dotstartech/nfc-terminal-proto/README.md

# nfc-terminal-proto
NFC Terminal Prototype
