dotstartech/nfc-terminal-proto/pcb/nfc-attachment/nfc-attachment.kicad_pcb

## KiCad design pcb/nfc-attachment/nfc-attachment.kicad_pcb (2025-09-16)

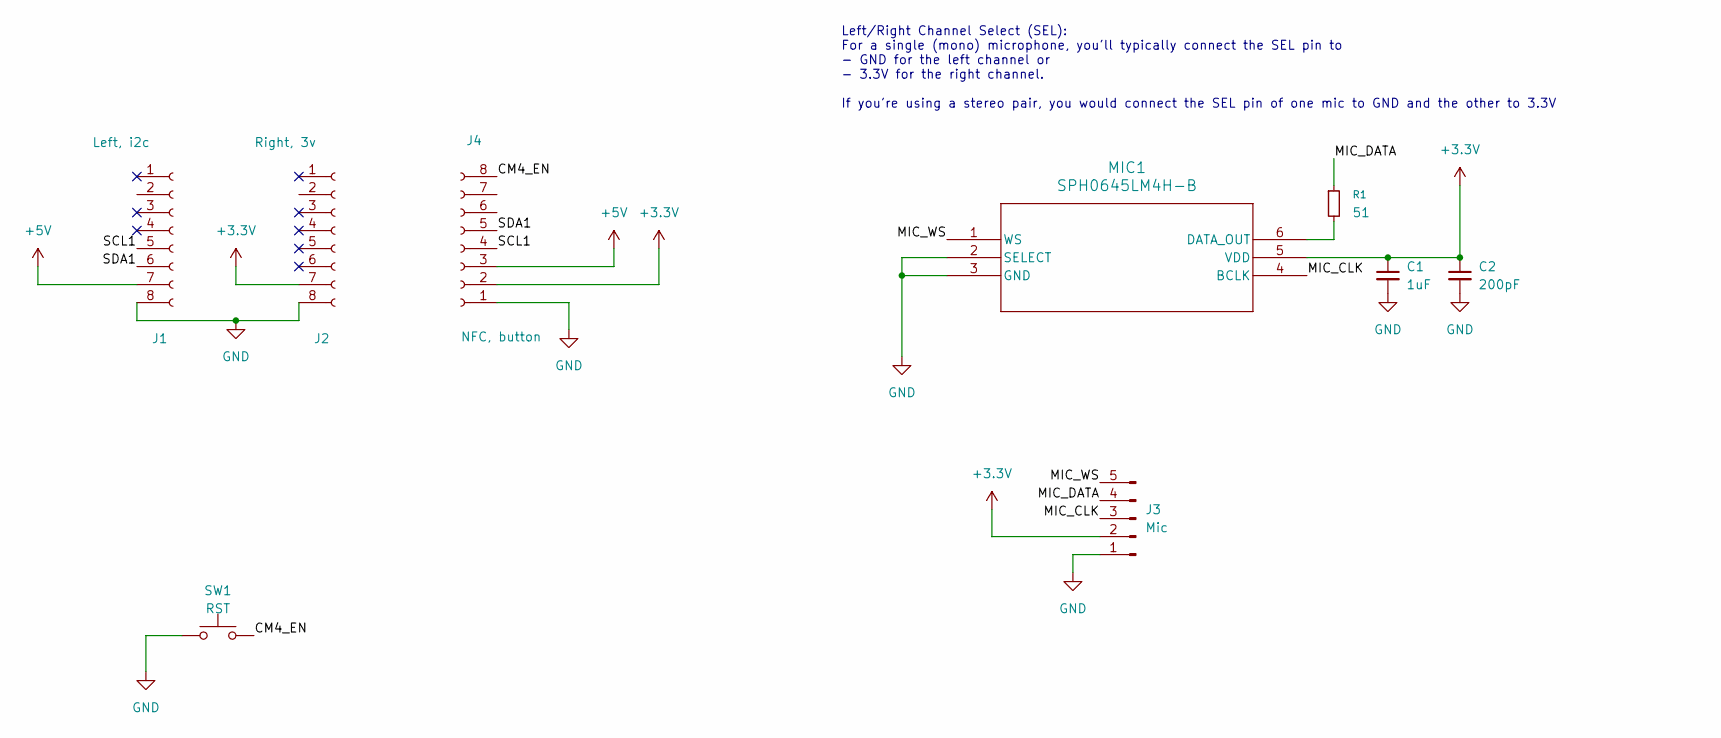
[picture p3: schematic nfc-attachment.kicad_sch]

Parts:
C1: 1uF; C_0603_1608Metric
C2: 200pF; C_0603_1608Metric
J1: Left, i2c; PinHeader_1x08_P2.54mm_Vertical
J2: Right, 3v; PinHeader_1x08_P2.54mm_Vertical
J3: Mic; PinHeader_1x05_P2.54mm_Vertical
J4: NFC, button; PinHeader_1x08_P2.54mm_Vertical
MIC1: SPH0645LM4H-B; SPH0645LM4H-B_KNO
R1: 51; R_0402_1005Metric
SW1: RST; SW_SPST_PTS810; LCSC C116501

Connections:
+3.3V: C1.1, C2.1, J2.7, J3.2, J4.2, MIC1.5 (VDD)
+5V: J1.7, J4.3
/CM4_EN: J4.8, SW1.2
/MIC_CLK: J3.3, MIC1.4 (BCLK)
/MIC_DATA: J3.4, R1.1
/MIC_WS: J3.5, MIC1.1 (WS)
/SCL1: J1.5, J4.4
/SDA1: J1.6, J4.5
GND: C1.2, C2.2, J1.8, J2.8, J3.1, J4.1, MIC1.2 (SELECT), MIC1.3 (GND), SW1.1
unnamed: MIC1.6 (DATA_OUT), R1.2

Notes on the sheet:
Left/Right Channel Select (SEL): For a single (mono) microphone, you'll typically connect the SEL pin to - GND for the left channel or - 3.3V for the right channel. If you're using a stereo pair, you would connect the SEL pin of one mic to GND and the other to 3.3V

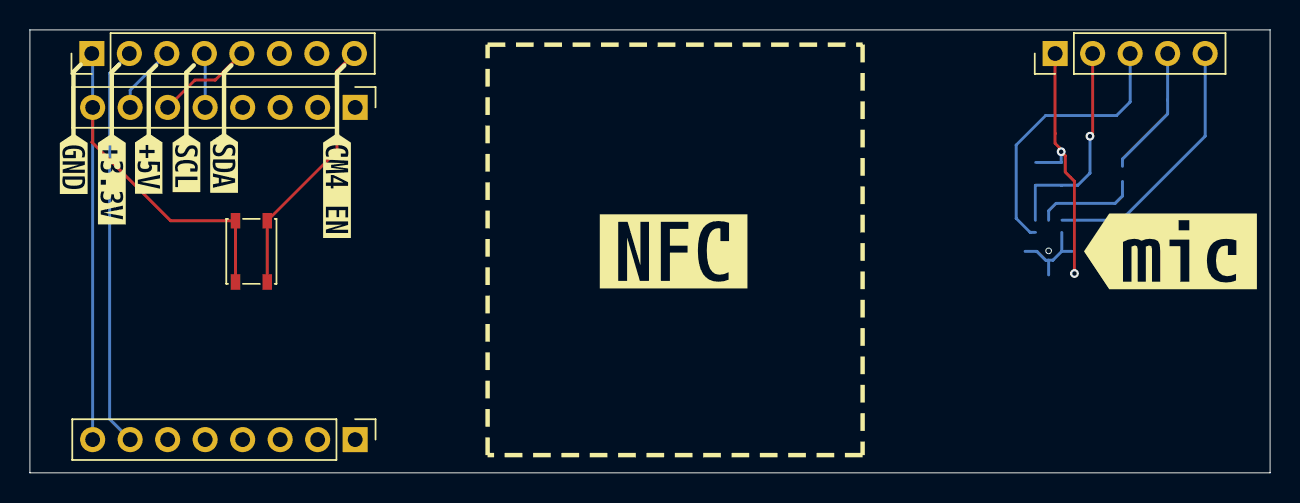
[picture p4: board nfc-attachment.kicad_pcb from above]

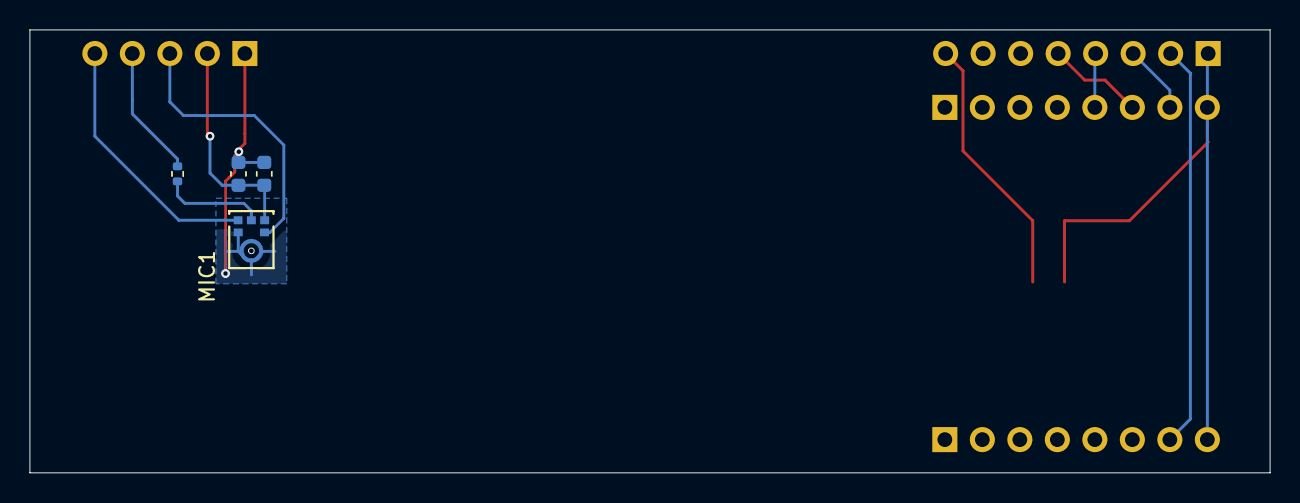
[picture p5: board nfc-attachment.kicad_pcb from below]

Board: 2 copper layers, 84.0 x 30.0 mm, 17 parts (4 on the bottom side), 10 nets.

Other parts of the board:
kibuzzard-68ADC165: G***; kibuzzard-68ADC165
kibuzzard-68ADC191: G***; kibuzzard-68ADC191
kibuzzard-68AEE2C2: G***; kibuzzard-68AEE2C2
kibuzzard-68AEE2D0: G***; kibuzzard-68AEE2D0
kibuzzard-68AEE2DF: G***; kibuzzard-68AEE2DF
kibuzzard-68AEE21F: G***; kibuzzard-68AEE21F
kibuzzard-68AEE211: G***; kibuzzard-68AEE211
kibuzzard-68AEE235: G***; kibuzzard-68AEE235
