dotstartech/nfc-terminal-proto/pcb/poe-back-plate/poe-back-plate.kicad_pcb

## KiCad design pcb/poe-back-plate/poe-back-plate.kicad_pcb (2025-09-16)

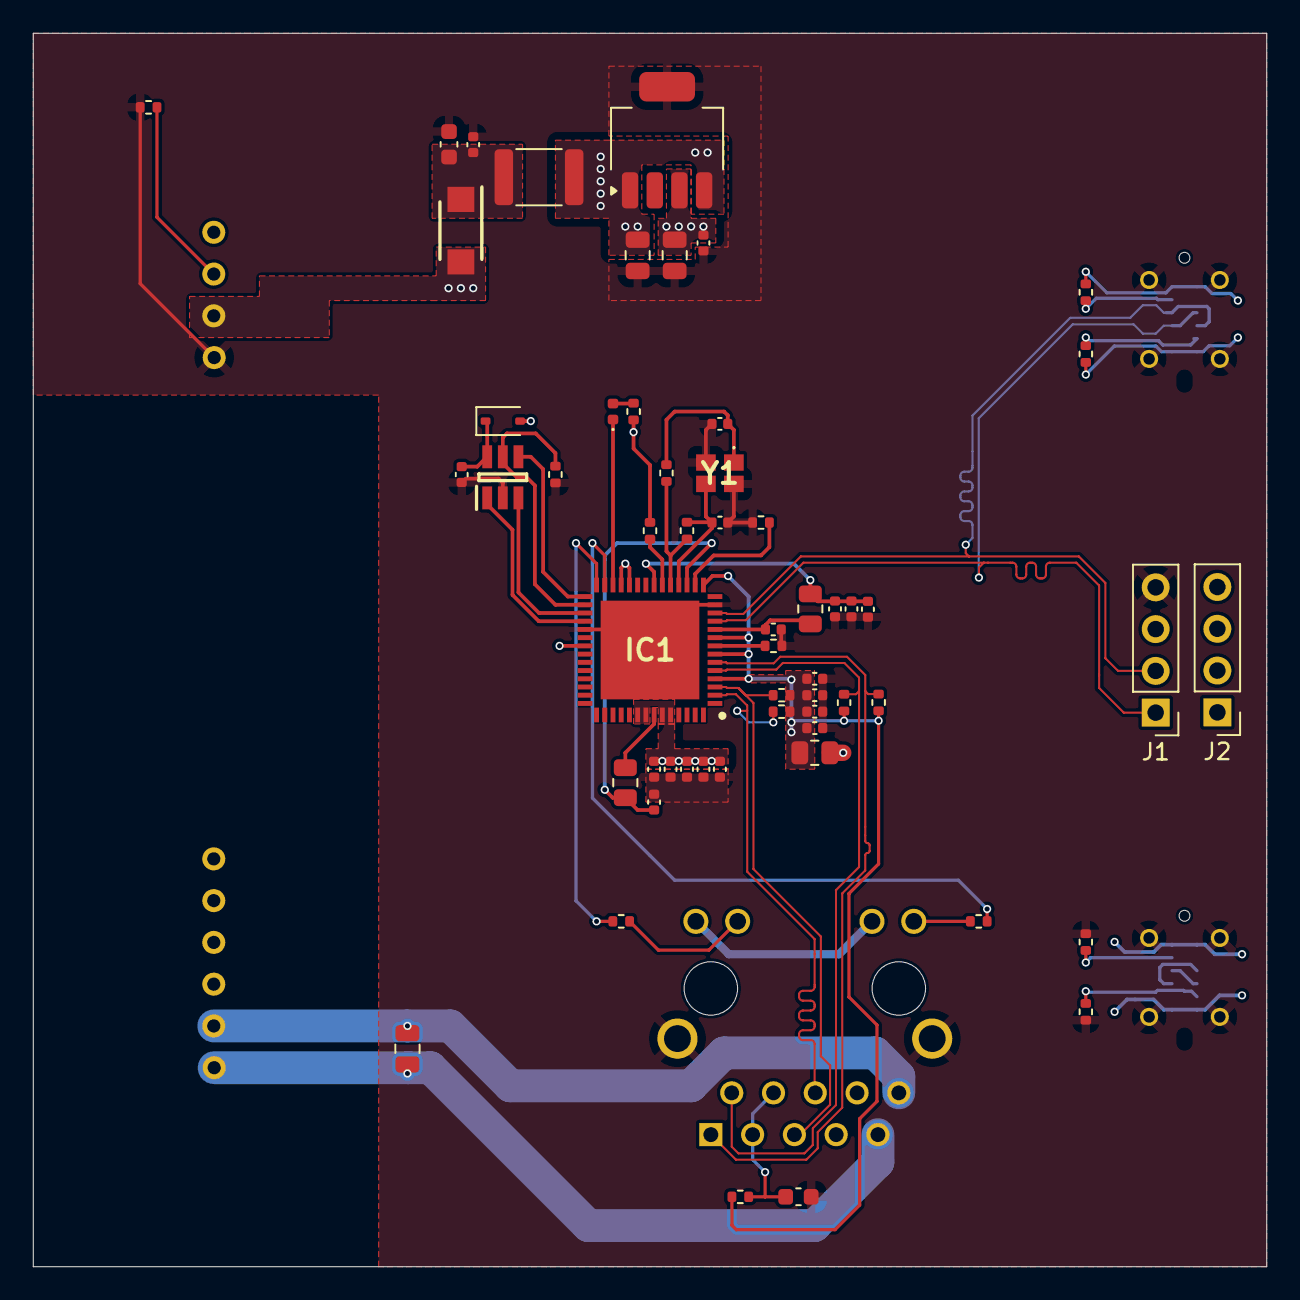
[picture p6: board poe-back-plate.kicad_pcb from above]

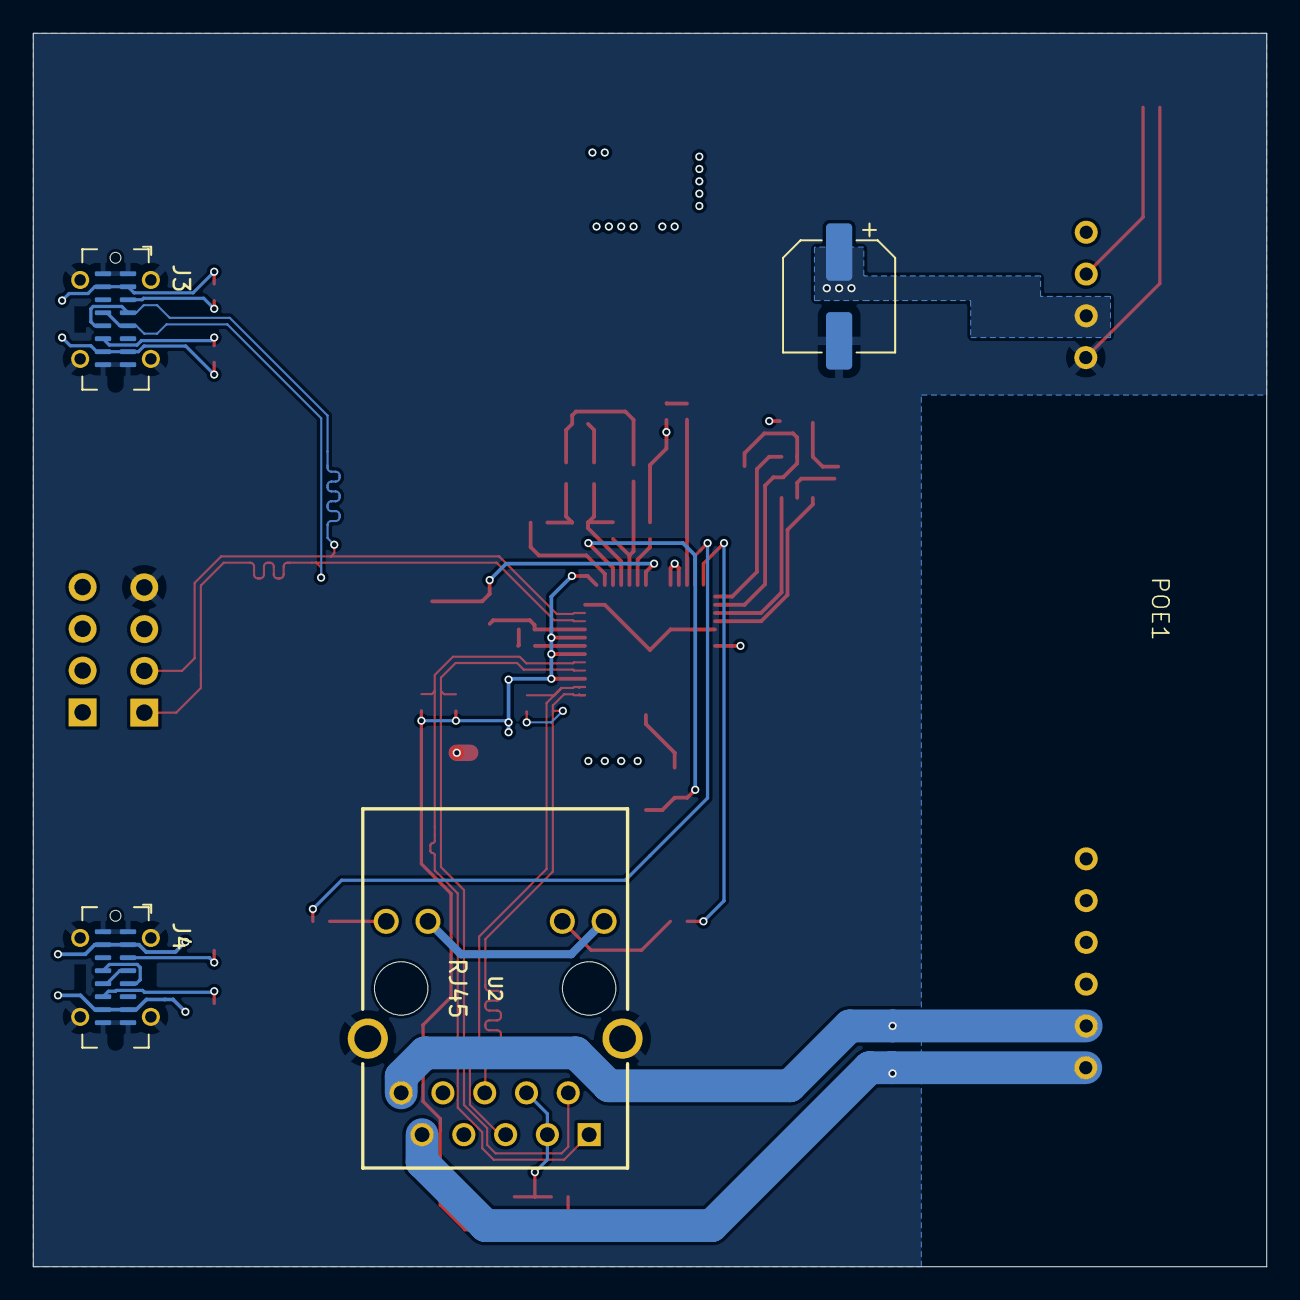
[picture p7: board poe-back-plate.kicad_pcb from below]

Board: 6 copper layers, 75.0 x 75.0 mm, 61 parts (5 on the bottom side), 42 nets.

Parts:
C1, C2, C3, C4, C5, C6, C7, C8, C9, C11, C12, C13, C14, C16, C20, C22: 100nF; C_0402_1005Metric
C10: 1uF; C_0402_1005Metric
C15, C18: 24pF; C_0402_1005Metric
C17, C19: 1uF; C_0805_2012Metric
C21: 1uF; C_0603_1608Metric
C23: 22nF; C_0603_1608Metric
C24: 10nF; C_0805_2012Metric
C25: 470µF; CP_Elec_6.3x7.7
D1: GREEN; LED_0402_1005Metric
D2: B0540WS; D_SOD-323
D3: SS54F; SODFL4626X120N
FB1, FB2, FB3: BLM21PG221SN1D; R_0805_2012Metric
FB4: CBM453215U101T; R_1812_4532Metric
IC1: LAN9500A-ABZJ; QFN50P800X800X100-57N-D
IC2: 93LC66AT-I_OT; SOT95P270X145-6N
J1: USB + Power; PinHeader_1x04_P2.54mm_Vertical
J2: UART + I2C; PinHeader_1x04_P2.54mm_Vertical
J3, J4: USB_C_Receptacle_USB2.0_14P; USB_C_Receptacle_G-Switch_GT-USB-7051x
POE1: AG5405
R1, R2: 12K; R_0402_1005Metric
R3, R5: 0; R_0402_1005Metric
R4: 1M; R_0402_1005Metric
R6, R12, R13: 3.3K; R_0402_1005Metric
R7: 10K; R_0402_1005Metric
R8, R10: 56K; R_0402_1005Metric
R9, R11: 5.1K; R_0402_1005Metric
R14: 10; R_0402_1005Metric
R15, R16, R17, R18: 49.9; R_0402_1005Metric
R19: 50K; R_0402_1005Metric
U1: LP38693MP-3.3; SOT-223-5
U2: HY931147C
Y1: ECS-250-18-36B2-CTY-TR; ECS2501836B2CTYTR

Connections:
+3.3V: C1.2, C2.2, C4.2, C6.2, C8.2, C19.2, C20.2, D2.2 (A), FB1.1, IC1.24 (NRESET), IC1.25 (VDD33IO_1), IC1.35 (VDD33IO_2), IC1.48 (VDD33IO_3), IC1.49 (TEST1), IC1.51 (VDD33IO_4), IC1.52 (VDD33IO_5), R3.1, R6.2, U1.3 (OUT), U2.P$11 (Y+), U2.P$13 (G+)
+5V: C17.2, FB4.2, J1.3, J3.A4 (VBUS), J3.A9 (VBUS), J3.B4 (VBUS), J3.B9 (VBUS), J4.A4 (VBUS), J4.A9 (VBUS), J4.B4 (VBUS), J4.B9 (VBUS), R8.2, R10.2, U1.1 (EN), U1.4 (IN)
/PoE/ETH1_LEDG: IC1.27 (NLNKA_LED/GPIO9), R12.2
/PoE/ETH1_LEDY: IC1.28 (NSPD_LED/GPIO10), R13.2
/PoE/POE_5V: C21.1, C22.1, D3.1 (K), FB4.1
/PoE/RXN: IC1.5 (RXN), R15.2, U2.P$2 (RX-)
/PoE/RXP: IC1.6 (RXP), R16.2, U2.P$1 (RX+)
/PoE/TXN: IC1.2 (TXN), R17.2, U2.P$6 (TX-)
/PoE/TXP: IC1.3 (TXP), R18.2, U2.P$5 (TX+)
/PoE/VDD33A: C3.2, C5.2, C7.2, C9.2, FB1.2, IC1.4 (VDD33A_1), IC1.7 (NC_1), IC1.9 (VDD33A_2), IC1.15 (VDD33A_3), R14.1, R15.1, R16.1, R17.1, R18.1
/USB to Ethernet/CRYSTAL_XI: C18.2, IC1.18 (XI), R4.2, Y1.3 (OUT/IN)
/USB to Ethernet/CRYSTAL_XO: IC1.19 (XO), R4.1, R5.1
/USB to Ethernet/EECLK_GPIO3: IC1.29 (EECLK/PWR_SEL), IC2.4 (CLK)
/USB to Ethernet/EECS_GPIO0: IC1.30 (EECS), IC2.5 (CS), R7.1
/USB to Ethernet/EEDI_GPIO1: IC1.32 (EEDI), IC2.1 (DO)
/USB to Ethernet/EEDO_GPIO2: IC1.31 (EEDO/AUTOMDIX_EN), IC2.3 (DI)
/USB to Ethernet/ETH1_LED_FDX: D1.1 (K), IC1.26 (NFDX_LED/GPIO8)
/USB to Ethernet/USBDN: IC1.11 (USBDM), J1.1, J3.A7 (D-), J3.B7 (D-)
/USB to Ethernet/USBDP: IC1.12 (USBDP), J1.2, J3.A6 (D+), J3.B6 (D+)
/USB to Ethernet/VDDCORE: C10.2, C11.2, C12.2, FB2.1, FB3.1, IC1.21 (VDDCORE_1), IC1.50 (VDDCORE_2)
/USB to Ethernet/VDDPLL: C14.2, FB3.2, IC1.10 (VDDPLL)
/USB to Ethernet/VDDUSBPLL: C13.2, FB2.2, IC1.17 (VDDUSBPLL)
GND: C1.1, C2.1, C3.1, C4.1, C5.1, C6.1, C7.1, C8.1, C9.1, C10.1, C11.1, C12.1, C13.1, C14.1, C15.1, C16.1, C17.1, C18.1, C19.1, C20.1, C21.2, C22.2, C23.2, C25.2, IC1.13 (TEST2), IC1.33 (TEST3), IC1.57 (VSS), IC2.2 (VSS), J1.4, J3.A1 (GND), J3.A12 (GND), J3.B1 (GND), J3.B12 (GND), J3.S1 (SHIELD), J4.A1 (GND), J4.A12 (GND), J4.B1 (GND), J4.B12 (GND), J4.S1 (SHIELD), POE1.7 (-VDC), R1.1, R2.1, R7.2, R9.2, R11.2, R19.2, U1.5 (GND), U2.GND1, U2.GND2, Y1.2 (GND_1), Y1.4 (GND_2)
unnamed: D1.2 (A), R6.1
unnamed: C16.2, D2.1 (K), IC2.6 (VCC)
unnamed: C25.1, D3.2 (A), POE1.8 (+VDC_)
unnamed: IC1.8 (EXRES), R1.2
unnamed: IC1.16 (USBRBIAS), R2.2
unnamed: IC1.20 (VBUS_DET), R3.2
unnamed: J3.A5 (CC1), R8.1
unnamed: J3.B5 (CC2), R10.1
unnamed: J4.A5 (CC1), R9.1
unnamed: J4.B5 (CC2), R11.1
unnamed: J4.A6 (D+), J4.B6 (D+)
unnamed: J4.A7 (D-), J4.B7 (D-)
unnamed: POE1.9 (ADJ), R19.1
unnamed: C24.1, POE1.1 (VIN+), U2.P$9 (V+)
unnamed: C24.2, POE1.2 (VIN-), U2.P$10 (V-)
unnamed: R12.1, U2.P$14 (G-)
unnamed: C23.1, R14.2, U2.P$3 (RXCT), U2.P$4 (TXCT)
unnamed: R13.1, U2.P$12 (Y-)
unnamed: C15.2, R5.2, Y1.1 (IN/OUT)
