dotstartech/nfc-terminal-proto/pcb/nfc-terminal-cm4-carrier/CM4IOv5.kicad_pcb

## KiCad design pcb/nfc-terminal-cm4-carrier/CM4IOv5.kicad_pcb (2025-09-16)

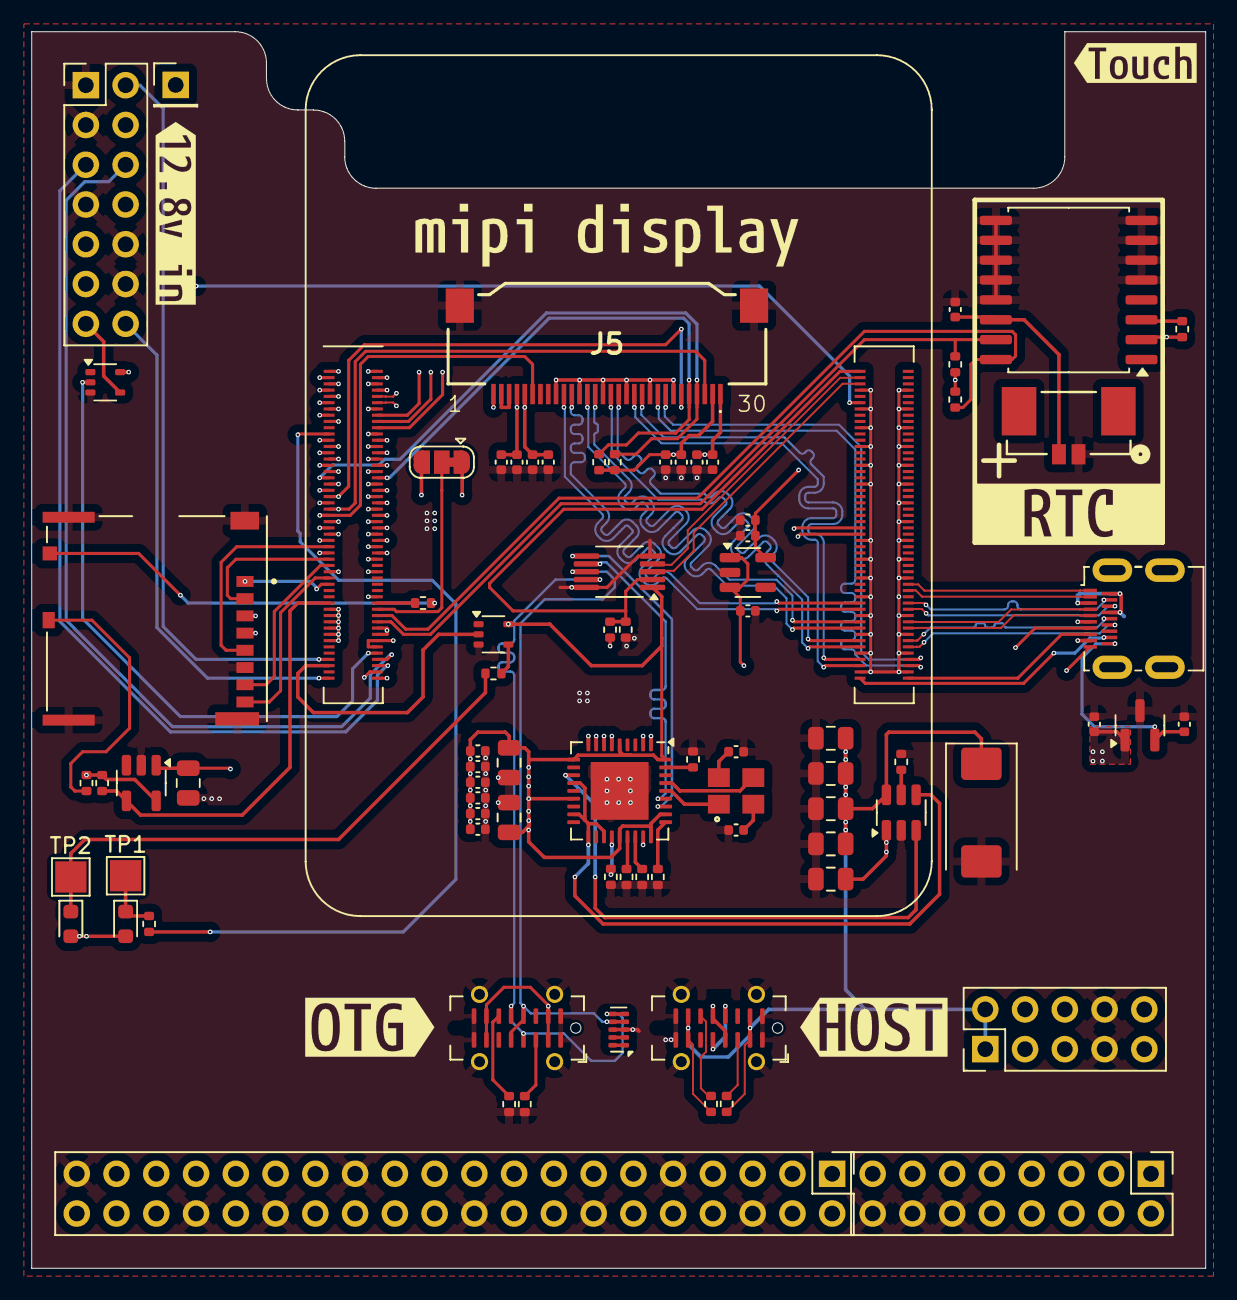
[picture p8: board CM4IOv5.kicad_pcb from above]

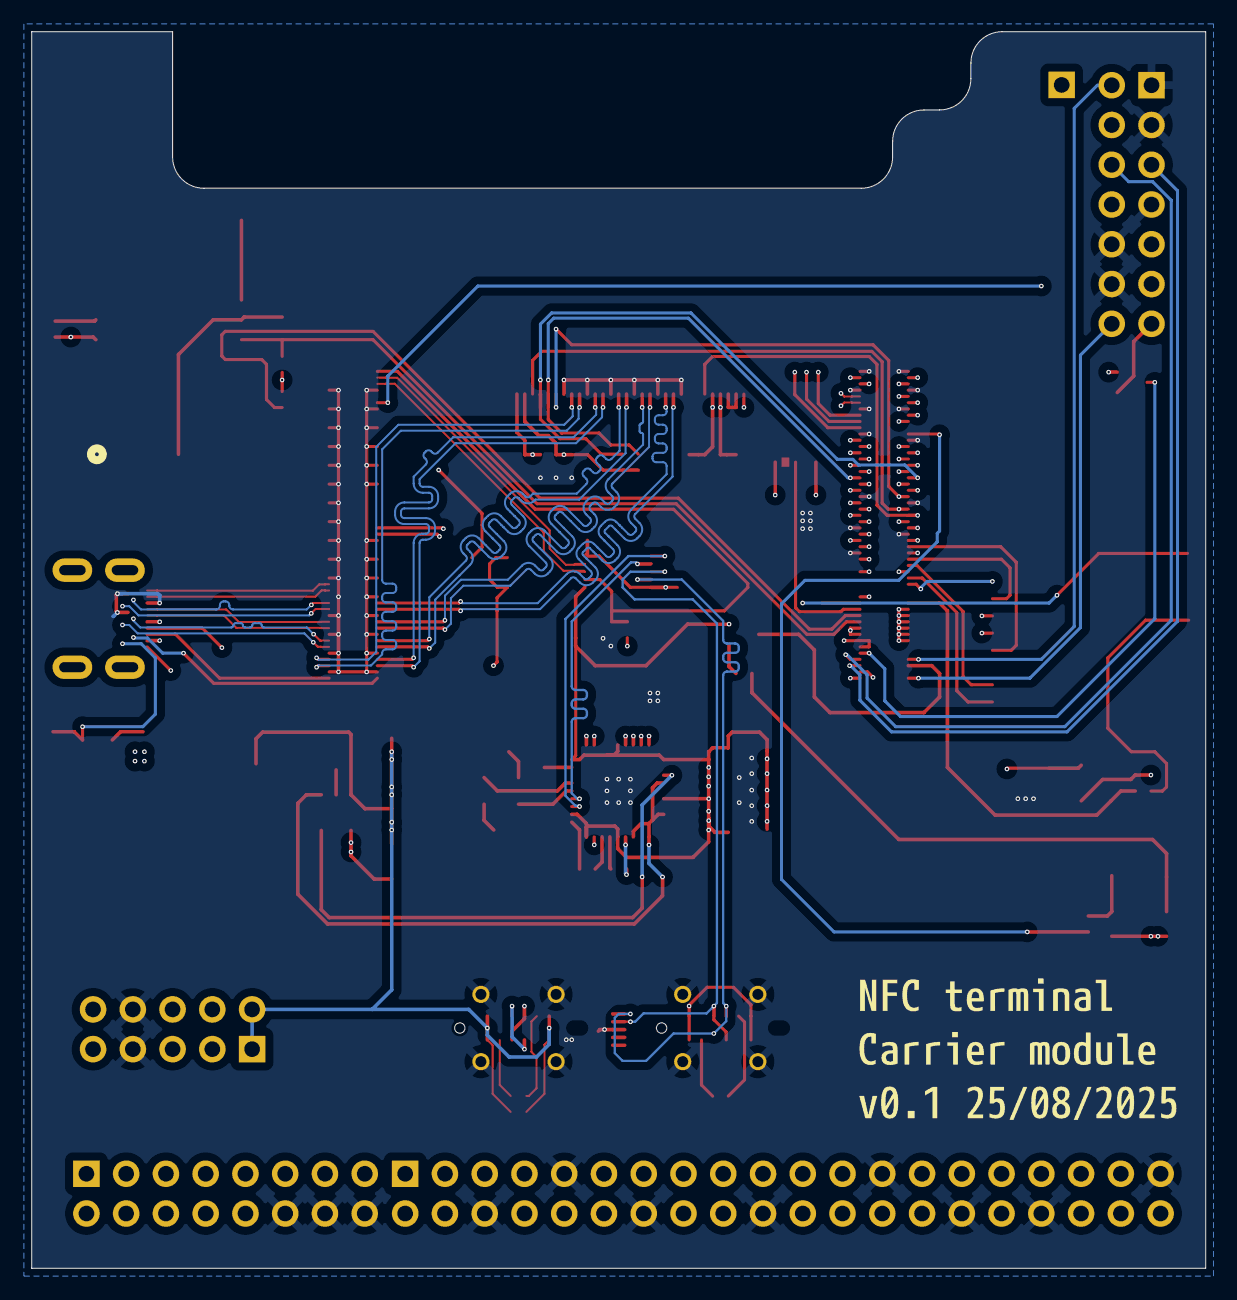
[picture p9: board CM4IOv5.kicad_pcb from below]

Board: 6 copper layers, 75.0 x 79.0 mm, 89 parts (2 on the bottom side), 132 nets.

Parts:
C1, C2: 27pF; C_0402_1005Metric
C3, C4, C11, C13, C14, C15, C16, C31: 10u; C_0805_2012Metric
C5, C6, C7, C8, C9, C10, C17, C18, C19, C22, C23, C24, C27, C28: 100n; C_0402_1005Metric
C12: 100uF; CP_EIA-7343-31_Kemet-D
C20, C21: 10uF; C_0402_1005Metric
C25, C26, C29, C30: 1uF; C_0402_1005Metric
D1: LED Green; LED_0603_1608Metric
D2: LED Red; LED_0603_1608Metric
J1, J2: USB_C_Receptacle_USB2.0_14P; USB_C_Receptacle_G-Switch_GT-USB-7051x
J3: Conn_02x05_Odd_Even; PinHeader_2x05_P2.54mm_Vertical
J4: Conn_01x02_Socket; CONN02_533984002_MOL
J5: F31L-1A7H1-11030; F31L1A7H111030
J6: 690-019-298-412; HDMI_Micro-D_Molex_46765-1x01
J7: Conn_02x07_Odd_Even; PinHeader_2x07_P2.54mm_Vertical
J10: THD-20-R; PinHeader_2x20_P2.54mm_Vertical
J15: THD-20-R; PinHeader_2x08_P2.54mm_Vertical
J16: Micro_SD_Card_Det; SDCARD_MOLEX_503398-1892
J17: UART; PinHeader_1x01_P2.54mm_Vertical
JP1: GPIO reference; SolderJumper-3_P1.3mm_Bridged12_RoundedPad1.0x1.5mm
Module1: ComputeModule4; Raspberry-Pi-4-Compute-Module
R1, R2, R14, R15: 2.2K 1%; R_0402_1005Metric
R3, R4, R5, R7: 36K 1%; R_0402_1005Metric
R6, R22: 12K 1%; R_0402_1005Metric
R8, R9: 5.1k; R_0402_1005Metric
R10, R12: 56K; R_0402_1005Metric
R11: 15K 1%; R_0402_1005Metric
R13: 10K; R_0402_1005Metric
R16, R19: 1k; R_0402_1005Metric
R20, R21: nf; R_0402_1005Metric
R23, R24: 4.7k; R_0402_1005Metric
TP1, TP2: TestPoint; TestPoint_Pad_2.0x2.0mm
U1: FSUSB42MUX; MSOP-10_3x3mm_P0.5mm
U2: USB2514B-I/M2; QFN-36-1EP_6x6mm_P0.5mm_EP3.7x3.7mm
U3: TPD4EUSB30; USON-10_2.5x1.0mm_P0.5mm
U4: AP22653W6; SOT-23-6
U5: DS3231M; SOIC-16W_7.5x10.3mm_P1.27mm
U6: RT9742SNGV; SOT-23
U7: LP5907MFX-2.8; SOT-23-5
U8, U9: 74LVC1G07SE-7; SOT-353_SC-70-5
U10: RT9742GGJ5; SOT-23-5
Y1: ABM8G-24.000MHZ-18-D2Y-T; ABM8G
kibuzzard-68AB3D2F: G***; kibuzzard-68AB3D2F
kibuzzard-68AB3EB0: G***; kibuzzard-68AB3EB0
kibuzzard-68AB3F8D: G***; kibuzzard-68AB3F8D
kibuzzard-68AB3F22: G***; kibuzzard-68AB3F22
kibuzzard-68AB3FA7: G***; kibuzzard-68AB3FA7
kibuzzard-68AB540C: G***; kibuzzard-68AB540C
kibuzzard-68AC31CB: G***; kibuzzard-68AC31CB
kibuzzard-68AC3314: G***; kibuzzard-68AC3314

Connections:
+2.8v: C21.2, C22.2, C24.1, C26.1, C28.1, C30.1, J5.4 (VCI_4), J5.5 (IOVCC_5), U7.5 (OUT)
/+3.3v: C3.1, C4.1, C5.1, C6.1, C7.1, C8.1, C9.1, C10.1, C20.2, C23.1, C25.1, C27.1, C29.1, D1.2 (A), D2.2 (A), J5.29 (TP_VCI_29), J5.30 (TP_IOVCC_30), J10.1, J10.17, J15.15, JP1.1 (A), Module1.84 (+3.3v_(Output)), Module1.86 (+3.3v_(Output)), R13.2, R14.1, R15.1, R20.1, R22.1, R23.1, R24.1, U1.1 (VCC), U2.5 (VDDA33), U2.10 (VDDA33), U2.15 (VDD33), U2.23 (VDD33), U2.27 (VBUS_DET), U2.29 (VDDA33), U2.36 (VDDA33), U5.2 (VCC), U7.1 (IN), U7.3 (EN), U9.5 (VCC), U10.5 (IN)
/+5v: C11.1, C18.1, J10.2, J10.4, J15.13, Module1.77 (+5v_(Input)), Module1.79 (+5v_(Input)), Module1.81 (+5v_(Input)), Module1.83 (+5v_(Input)), Module1.85 (+5v_(Input)), Module1.87 (+5v_(Input)), U4.1 (IN), U6.1 (IN), U8.5 (VCC)
/CM4_GPIO ( Ethernet, GPIO, SDCARD)/+1.8v: JP1.3 (B), Module1.88 (+1.8v_(Output)), Module1.90 (+1.8v_(Output))
/CM4_GPIO ( Ethernet, GPIO, SDCARD)/AIN0: J7.5, Module1.96 (AnalogIP0)
/CM4_GPIO ( Ethernet, GPIO, SDCARD)/AIN1: J7.6, Module1.94 (AnalogIP1)
/CM4_GPIO ( Ethernet, GPIO, SDCARD)/EEPROM_nWP: J7.4, Module1.20 (EEPROM_nWP)
/CM4_GPIO ( Ethernet, GPIO, SDCARD)/ETH_LEDG: J15.9, Module1.17 (Ethernet_nLED2(3.3v))
/CM4_GPIO ( Ethernet, GPIO, SDCARD)/ETH_LEDY: J15.10, Module1.15 (Ethernet_nLED3(3.3v))
/CM4_GPIO ( Ethernet, GPIO, SDCARD)/GLOBAL_EN: J7.14, Module1.99 (Global_EN)
/CM4_GPIO ( Ethernet, GPIO, SDCARD)/GPIO2: J10.3, Module1.58 (GPIO2)
/CM4_GPIO ( Ethernet, GPIO, SDCARD)/GPIO3: J10.5, Module1.56 (GPIO3)
/CM4_GPIO ( Ethernet, GPIO, SDCARD)/GPIO4: J10.7, Module1.54 (GPIO4)
/CM4_GPIO ( Ethernet, GPIO, SDCARD)/GPIO5: J10.29, Module1.34 (GPIO5)
/CM4_GPIO ( Ethernet, GPIO, SDCARD)/GPIO6: J10.31, Module1.30 (GPIO6)
/CM4_GPIO ( Ethernet, GPIO, SDCARD)/GPIO7: J10.26, Module1.37 (GPIO7)
/CM4_GPIO ( Ethernet, GPIO, SDCARD)/GPIO8: J10.24, Module1.39 (GPIO8)
/CM4_GPIO ( Ethernet, GPIO, SDCARD)/GPIO9: J10.21, Module1.40 (GPIO9)
/CM4_GPIO ( Ethernet, GPIO, SDCARD)/GPIO10: J10.19, Module1.44 (GPIO10)
/CM4_GPIO ( Ethernet, GPIO, SDCARD)/GPIO11: J10.23, Module1.38 (GPIO11)
/CM4_GPIO ( Ethernet, GPIO, SDCARD)/GPIO12: J10.32, Module1.31 (GPIO12)
/CM4_GPIO ( Ethernet, GPIO, SDCARD)/GPIO13: J10.33, Module1.28 (GPIO13)
/CM4_GPIO ( Ethernet, GPIO, SDCARD)/GPIO14: J10.8, Module1.55 (GPIO14)
/CM4_GPIO ( Ethernet, GPIO, SDCARD)/GPIO15: J10.10, Module1.51 (GPIO15)
/CM4_GPIO ( Ethernet, GPIO, SDCARD)/GPIO16: J10.36, Module1.29 (GPIO16)
/CM4_GPIO ( Ethernet, GPIO, SDCARD)/GPIO17: J10.11, Module1.50 (GPIO17)
/CM4_GPIO ( Ethernet, GPIO, SDCARD)/GPIO18: J10.12, Module1.49 (GPIO18)
/CM4_GPIO ( Ethernet, GPIO, SDCARD)/GPIO19: J10.35, Module1.26 (GPIO19)
/CM4_GPIO ( Ethernet, GPIO, SDCARD)/GPIO20: J10.38, Module1.27 (GPIO20)
/CM4_GPIO ( Ethernet, GPIO, SDCARD)/GPIO21: J10.40, Module1.25 (GPIO21)
/CM4_GPIO ( Ethernet, GPIO, SDCARD)/GPIO22: J10.15, Module1.46 (GPIO22)
/CM4_GPIO ( Ethernet, GPIO, SDCARD)/GPIO23: J5.6 (RESET_6), J10.16, Module1.47 (GPIO23)
/CM4_GPIO ( Ethernet, GPIO, SDCARD)/GPIO24: J5.28 (TP_RESET_28), J10.18, Module1.45 (GPIO24)
/CM4_GPIO ( Ethernet, GPIO, SDCARD)/GPIO25: J5.25 (TP_INT_25), J10.22, Module1.41 (GPIO25)
/CM4_GPIO ( Ethernet, GPIO, SDCARD)/GPIO26: J10.37, Module1.24 (GPIO26)
/CM4_GPIO ( Ethernet, GPIO, SDCARD)/GPIO27: J10.13, Module1.48 (GPIO27)
/CM4_GPIO ( Ethernet, GPIO, SDCARD)/GPIO_VREF: JP1.2 (C), Module1.78 (GPIO_VREF(1.8v/3.3v_Input))
/CM4_GPIO ( Ethernet, GPIO, SDCARD)/ID_SC: J5.27 (TP_SCL_27), J10.28, Module1.35 (ID_SC), R15.2
/CM4_GPIO ( Ethernet, GPIO, SDCARD)/ID_SD: J5.26 (TP_SDA_26), J10.27, Module1.36 (ID_SD), R14.2
/CM4_GPIO ( Ethernet, GPIO, SDCARD)/RUN_PG: Module1.92 (RUN_PG), U8.2
/CM4_GPIO ( Ethernet, GPIO, SDCARD)/Reserved: Module1.76 (Reserved), R21.1
/CM4_GPIO ( Ethernet, GPIO, SDCARD)/SCL0: Module1.80 (SCL0), R24.2, U5.16 (SCL)
/CM4_GPIO ( Ethernet, GPIO, SDCARD)/SDA0: Module1.82 (SDA0), R23.2, U5.15 (SDA)
/CM4_GPIO ( Ethernet, GPIO, SDCARD)/SD_CLK: J16.5 (CLK), Module1.57 (SD_CLK)
/CM4_GPIO ( Ethernet, GPIO, SDCARD)/SD_CMD: J16.3 (CMD), Module1.62 (SD_CMD)
/CM4_GPIO ( Ethernet, GPIO, SDCARD)/SD_DAT0: J16.7 (DAT0), Module1.63 (SD_DAT0)
/CM4_GPIO ( Ethernet, GPIO, SDCARD)/SD_DAT1: J16.8 (DAT1), Module1.67 (SD_DAT1)
/CM4_GPIO ( Ethernet, GPIO, SDCARD)/SD_DAT2: J16.1 (DAT2), Module1.69 (SD_DAT2)
/CM4_GPIO ( Ethernet, GPIO, SDCARD)/SD_DAT3: J16.2 (DAT3/CD), Module1.61 (SD_DAT3)
/CM4_GPIO ( Ethernet, GPIO, SDCARD)/SD_PWR: C31.1, J16.4 (VDD), U10.1 (OUT)
/CM4_GPIO ( Ethernet, GPIO, SDCARD)/SD_PWR_ON: Module1.75 (SD_PWR_ON), R22.2, U10.4 (EN)
/CM4_GPIO ( Ethernet, GPIO, SDCARD)/SYNC_IN: J7.8, Module1.16 (Ethernet_SYNC_IN(1.8v))
/CM4_GPIO ( Ethernet, GPIO, SDCARD)/SYNC_OUT: J7.9, Module1.18 (Ethernet_SYNC_OUT(1.8v))
/CM4_GPIO ( Ethernet, GPIO, SDCARD)/TRD0_N: J15.2, Module1.10 (Ethernet_Pair0_N)
/CM4_GPIO ( Ethernet, GPIO, SDCARD)/TRD0_P: J15.1, Module1.12 (Ethernet_Pair0_P)
/CM4_GPIO ( Ethernet, GPIO, SDCARD)/TRD1_N: J15.4, Module1.6 (Ethernet_Pair1_N)
/CM4_GPIO ( Ethernet, GPIO, SDCARD)/TRD1_P: J15.3, Module1.4 (Ethernet_Pair1_P)
/CM4_GPIO ( Ethernet, GPIO, SDCARD)/TRD2_N: J15.6, Module1.9 (Ethernet_Pair2_N)
/CM4_GPIO ( Ethernet, GPIO, SDCARD)/TRD2_P: J15.5, Module1.11 (Ethernet_Pair2_P)
/CM4_GPIO ( Ethernet, GPIO, SDCARD)/TRD3_N: J15.8, Module1.5 (Ethernet_Pair3_N)
/CM4_GPIO ( Ethernet, GPIO, SDCARD)/TRD3_P: J15.7, Module1.3 (Ethernet_Pair3_P)
/CM4_GPIO ( Ethernet, GPIO, SDCARD)/TV_OUT: J7.11, Module1.111 (VDAC_COMP)
/CM4_GPIO ( Ethernet, GPIO, SDCARD)/nPWR_LED: Module1.95 (nPI_LED_PWR), U9.2
/CM4_GPIO ( Ethernet, GPIO, SDCARD)/nRPIBOOT: J7.2, Module1.93 (nRPIBOOT)
/CM4_HighSpeed/+12.8v: J5.1 (LEDA_1), J17.1
/CM4_HighSpeed/DSI1_C_N: J5.17 (CLKN_17), Module1.187 (DSI1_C_N)
/CM4_HighSpeed/DSI1_C_P: J5.16 (CLKP_16), Module1.189 (DSI1_C_P)
/CM4_HighSpeed/DSI1_D0_N: J5.11 (MIPI_0N_11), Module1.175 (DSI1_D0_N)
/CM4_HighSpeed/DSI1_D0_P: J5.10 (MIPI_0P_10), Module1.177 (DSI1_D0_P)
/CM4_HighSpeed/DSI1_D1_N: J5.14 (MIPI_1N_14), Module1.181 (DSI1_D1_N)
/CM4_HighSpeed/DSI1_D1_P: J5.13 (MIPI_1P_13), Module1.183 (DSI1_D1_P)
/CM4_HighSpeed/DSI1_D2_N: J5.20 (MIPI_2N__20), Module1.193 (DSI1_D2_N)
/CM4_HighSpeed/DSI1_D2_P: J5.19 (MIPI_2P_19), Module1.195 (DSI1_D2_P)
/CM4_HighSpeed/DSI1_D3_N: J5.23 (MIPI_3N_23), Module1.194 (DSI1_D3_N)
/CM4_HighSpeed/DSI1_D3_P: J5.22 (MIPI_3P_22), Module1.196 (DSI1_D3_P)
/CM4_HighSpeed/HDMI0_CEC: J6.13 (CEC), Module1.151 (HDMI0_CEC)
/CM4_HighSpeed/HDMI0_CK_N: J6.12 (CK-), Module1.190 (HDMI0_CLK_N)
/CM4_HighSpeed/HDMI0_CK_P: J6.10 (CK+), Module1.188 (HDMI0_CLK_P)
/CM4_HighSpeed/HDMI0_D0_N: J6.9 (D0-), Module1.184 (HDMI0_TX0_N)
/CM4_HighSpeed/HDMI0_D0_P: J6.7 (D0+), Module1.182 (HDMI0_TX0_P)
/CM4_HighSpeed/HDMI0_D1_N: J6.6 (D1-), Module1.178 (HDMI0_TX1_N)
/CM4_HighSpeed/HDMI0_D1_P: J6.4 (D1+), Module1.176 (HDMI0_TX1_P)
/CM4_HighSpeed/HDMI0_D2_N: J6.3 (D2-), Module1.172 (HDMI0_TX2_N)
/CM4_HighSpeed/HDMI0_D2_P: J6.1 (D2+), Module1.170 (HDMI0_TX2_P)
/CM4_HighSpeed/HDMI0_HOTPLUG: J6.19 (HPD/HEAC-), Module1.153 (HDMI0_HOTPLUG)
/CM4_HighSpeed/HDMI0_SCL: J6.15 (SCL), Module1.200 (HDMI0_SCL)
/CM4_HighSpeed/HDMI0_SDA: J6.16 (SDA), Module1.199 (HDMI0_SDA)
/CM4_HighSpeed/HDMI_5v: C19.1, J6.18 (+5V), U6.2 (OUT)
/CM4_HighSpeed/USB2_N: Module1.103 (USB2_N), U1.4 (D_N)
/CM4_HighSpeed/USB2_P: Module1.105 (USB2_P), U1.3 (D_P)
/CM4_HighSpeed/USBOTG_ID: Module1.101 (USB_OTG_ID), R1.1, R2.2, U1.2 (SEL)
/RTC , Wakeup, FAN/nRTC_INT: R13.1, U5.3 (~INT/SQW)
/USB2-HUB/HD1_N: J2.A7 (D-), J2.B7 (D-), U2.1 (USBDM_DN1/PRT_DIS_M1)
/USB2-HUB/HD1_P: J2.A6 (D+), J2.B6 (D+), U2.2 (USBDP_DN1/PRT_DIS_P1)
/USB2-HUB/HD3_N: J3.3, U2.6 (USBDM_DN3/PRT_DIS_M3)
/USB2-HUB/HD3_P: J3.5, U2.7 (USBDP_DN3/PRT_DIS_P3)
/USB2-HUB/HD4_N: J3.4, U2.8 (USBDM_DN4/PRT_DIS_M4)
/USB2-HUB/HD4_P: J3.6, U2.9 (USBDP_DN4/PRT_DIS_P4)
/USB2-HUB/PWR1: U2.12 (PRTPWR1/BC_EN1), U4.3 (EN)
/USB2-HUB/USBD_N: J1.A7 (D-), J1.B7 (D-), U1.8 (HSD1_M), U3.4 (D2+), U3.7
/USB2-HUB/USBD_P: J1.A6 (D+), J1.B6 (D+), U1.9 (HSD1_P), U3.5 (D2-), U3.6
/USB2-HUB/USBH_N: U1.6 (HSD0_M), U2.30 (USBDM_UP)
/USB2-HUB/USBH_P: U1.7 (HSD0_P), U2.31 (USBDP_UP)
/USB2-HUB/VBUS: C12.1, C13.1, C14.1, C15.1, C16.1, J2.A4 (VBUS), J2.A9 (VBUS), J2.B4 (VBUS), J2.B9 (VBUS), J3.1, J3.2, R10.2, R12.2, U4.6 (OUT)
/USB2-HUB/nOCS1: U2.13 (OCS_N1), U2.17 (OCS_N2), U2.19 (OCS_N3), U2.21 (OCS_N4), U4.4 (nFault)
/nEXTRST: Module1.100 (nEXTRST), U2.26 (RESET_N)
GND: C1.2, C2.2, C3.2, C4.2, C5.2, C6.2, C7.2, C8.2, C9.2, C10.2, C11.2, C12.2, C13.2, C14.2, C15.2, C16.2, C17.2, C18.2, C19.2, C20.1, C21.1, C22.1, C23.2, C24.2, C25.2, C26.2, C27.2, C28.2, C29.2, C30.2, C31.2, J1.A1 (GND), J1.A12 (GND), J1.B1 (GND), J1.B12 (GND), J1.S1 (SHIELD), J2.A1 (GND), J2.A12 (GND), J2.B1 (GND), J2.B12 (GND), J2.S1 (SHIELD), J3.7, J3.8, J4.1, J5.2 (LEDK1_2), J5.3 (LEDK2_3), J5.9 (GND_9), J5.12 (GND_12), J5.15 (GND_15), J5.18 (GND_18), J5.21 (GND_21), J5.24 (GND_24), J5.31 (MP_1), J5.32 (MP_2), J6.2 (D2S), J6.5 (D1S), J6.8 (D0S), J6.11 (CKS), J6.17 (GND), J7.1, J7.3, J7.7, J7.10, J7.12, J10.6, J10.9, J10.14, J10.20, J10.25, J10.30, J10.34, J10.39, J15.12, J15.14, J15.16, J16.6 (VSS), J16.11 (SHIELD), Module1.1 (GND), Module1.2 (GND), Module1.7 (GND), Module1.8 (GND), Module1.13 (GND), Module1.14 (GND), Module1.22 (GND), Module1.23 (GND), Module1.32 (GND), Module1.33 (GND), Module1.42 (GND), Module1.43 (GND), Module1.52 (GND), Module1.53 (GND), Module1.59 (GND), Module1.60 (GND), Module1.65 (GND), Module1.66 (GND), Module1.71 (GND), Module1.74 (GND), Module1.98 (GND), Module1.107 (GND), Module1.108 (GND), Module1.113 (GND), Module1.114 (GND), Module1.119 (GND), Module1.120 (GND), Module1.125 (GND), Module1.126 (GND), Module1.131 (GND), Module1.132 (GND), Module1.137 (GND), Module1.138 (GND), Module1.144 (GND), Module1.150 (GND), Module1.155 (GND), Module1.156 (GND), Module1.161 (GND), Module1.162 (GND), Module1.167 (GND), Module1.168 (GND), Module1.173 (GND), Module1.174 (GND), Module1.179 (GND), Module1.180 (GND), Module1.185 (GND), Module1.186 (GND), Module1.191 (GND), Module1.192 (GND), Module1.197 (GND), Module1.198 (GND), R1.2, R3.2, R4.2, R5.2, R6.1, R7.2, R8.1, R9.1, R11.2, U1.5 (GND), U1.10 (nOE), U2.37 (VSS), U3.3 (GND), U3.8 (GND), U4.2 (GND), U5.5 (GND), U5.6 (GND), U5.7 (GND), U5.8 (GND), U5.9 (GND), U5.10 (GND), U5.11 (GND), U5.12 (GND), U5.13 (GND), U6.3 (GND), U7.2 (GND), U8.3 (GND), U9.3 (GND), U10.2 (GND)
unnamed: D1.1 (K), R16.1, TP1.1
unnamed: D2.1 (K), R19.1, TP2.1
unnamed: J1.A5 (CC1), R9.2
unnamed: J1.B5 (CC2), R8.2
unnamed: J1.A4 (VBUS), J1.A9 (VBUS), J1.B4 (VBUS), J1.B9 (VBUS), R2.1
unnamed: J2.A5 (CC1), R10.1
unnamed: J2.B5 (CC2), R12.1
unnamed: C17.1, J4.2, U5.14 (VBAT)
unnamed: J7.13, U8.4
unnamed: J16.10 (DET_A), R20.2
unnamed: J16.9 (DET_B), R21.2
unnamed: Module1.21 (PI_nLED_Activity), R16.2
unnamed: R19.2, U9.4
unnamed: R7.1, U2.25 (HS_IND/CFG_SEL1)
unnamed: R6.2, U2.35 (RBIAS)
unnamed: R3.1, U2.24 (SCL/SMBCLK/CFG_SEL0)
unnamed: R4.1, U2.22 (SDA/SMBDATA/NON_REM1)
unnamed: R5.1, U2.28 (SUSP_IND/LOCAL_PWR/NON_REM0)
unnamed: U2.33 (XTALIN/CLKIN), Y1.3 (XTAL_2)
unnamed: U2.32 (XTALOUT), Y1.1 (XTAL_1)
unnamed: U3.1 (D1+), U3.10
unnamed: U3.2 (D1-), U3.9
unnamed: R11.1, U4.5 (ILIM)
unnamed: C2.1, Y1.2 (GND_1)
unnamed: C1.1, Y1.4 (GND_2)
