dotstartech/nfc-terminal-proto/(notices)

Notices in the files:
pcb/nfc-terminal-cm4-carrier/PSUs.kicad_sch:
© 2020-2022 Raspberry Pi Ltd (formerly Raspberry Pi (Trading) Ltd.)
